bengtmartensson/AIRWidget/airwidget_scaled.jpg

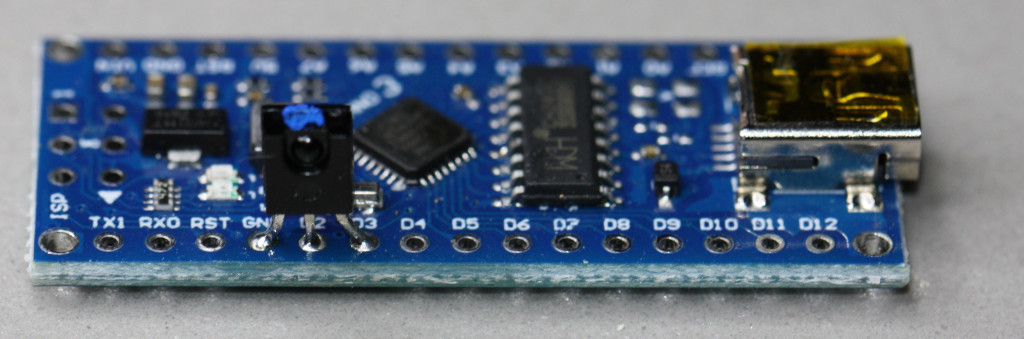
airwidget_scaled.jpg
