bengtmartensson/AIRWidget/README.txt

This project is a fork of Tommy Tyler's/Graham Dixon's AIRWidget,
located in
https://svn.code.sf.net/p/controlremote/code/trunk/airwidget .

Discussion Thread:
http://www.hifi-remote.com/forums/viewtopic.php?t=103169
