bengtmartensson/AIRWidget/(commit log)

2022-10-15 Refactor current setup into setup and loop. Move variable decls.
2022-11-04 Remove compatibility mode and rts sensoring
